minhhunghuynh/BA2-LIFI-communication/ba2-eit-lifi-main 2/Arduino/readme.md

# Arduino

Ce dossier contient les codes Arduino lié au projet 

Chaque code est accompagné de son schéma de connexion, de son *flowchart* et d'un *readme* expliquant son fonctionnement global.  
De plus, le code est commenté pour faciliter sa lecture.

Les schémas de connexion sont réalisés avec [KiCad](https://www.kicad.org) et les *flowcharts* avec [draw.io](https://www.drawio.com/).

## testRuban

Ce code permet de tester le fonctionnement d'un ruban LED en utilisant une *PWM output*.
