minhhunghuynh/BA2-LIFI-communication/ba2-eit-lifi-main 2/Documentation/readme.md

# Documentation

Ce dossier contient les documents utiles au projet :

- *documents de référence.md* contient les liens vers le cahier des charges et les notices des composanst fournis par la filière
