minhhunghuynh/BA2-LIFI-communication/ba2-eit-lifi-main 2/Gestion/Status reports/Q1/status_report_24_10_03.md

# Status report

- Groupe : 3
- Date : 3/10/2024

## Ordre du jour

- [Plan d'ensemble](#plan-d'ensemble)
- [Activités](#activités)
- [Risques et problèmes](#risques-et-problèmes)
- [Discussion de contenu](#discussions-de-contenu)

## Plan d'ensemble
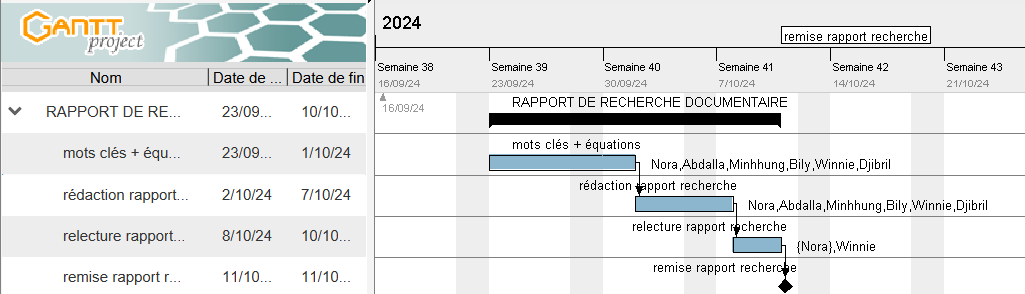
[picture p1: ba2-eit-lifi-main 2/Gestion/Status reports/plans ( images)/gantt_3_10.png]


## Activités
| Activités terminées la semaine passée | Activités planifiées la semaine prochaine | 
| --- | --- |
|Trouver les mots-clés pour la recherche documentaire |Recherche documentaire (trouver deux sources max par équation de recherche) |
|Chercher les infos sur les circuits(3 personnes responsable)  |Terminer la bibliographie pour dimanche au plus tard |
|Chercher et se renseigner sur le code en C++ (3 personnes nécessaire)  |Bily, Winnie et Minhhung vont devoir trouver un circuit test pour la semaine prochaine et comprendre comment cabler|
|  |(Djibril, Nora et Abdalla) vont devoir ramener pour la semaine prochaine un code pour faire allumer la lampe LED, test code|

## Risques et problèmes

Sous forme de **tableaux** mais en _Markdown_ pur, **il n'est pas possible d'afficher plusieurs lignes par cellule**.

**Solution 1** : utilisation d'une seule ligne par cellule et de la balise html `<br>` pour passer à la ligne

| Impact \ Probability | Medium | High | Issue  |
| --- | --- | --- | --- |
| **Medium** | **X** | <br> | |
| **High** | - pas de prototype<br>-prototype non fonctionnel |  | :warning: Problème à grand impact |

**Solution 2** : utilisation d'une rangée intermédiaire vide et de rangées supplémentaires en dessous de la ligne correspondante

| Impact \ Probability 	| Medium 	| High 	| Issue |
| -- 				 	| -- 		| -- 	| -- 	|
|  			 	 	|  		 |  	 |  	 |
| **High** 				| Risque 1 	| 	| 	|
|  				 	| Risque 2 	| 	| 	|
|  					 | 		 | 	| :warning:  Problème à grand impact |
|  				 	 |  		 |  	 |  	 |
| **Medium**			| **X**	| Risque 1 élevé | 	|
|  						| 		| Risque 2 élevé | 	|

**Solutions alternatives** : faites preuves d'imagination 

**NB** : pour la solution 1, l'impact medium se trouve en rangée 1 tandis que pour la solution 2, c'est l'inverse (cf. graphique du status_report original). A vous de choisir, ce que vous préférez comme solution. 

## Discussions de contenu
