minhhunghuynh/BA2-LIFI-communication/ba2-eit-lifi-main 2/Gestion/Status reports/Q1/status_report_24_11_28.md

# Status report

- Groupe : 3
- Date : 28/11/2024

## Ordre du jour

- [Plan d'ensemble](#plan-d'ensemble)
- [Activités](#activités)
- [Risques et problèmes](#risques-et-problèmes)
- [Discussion de contenu](#discussions-de-contenu)

## Plan d'ensemble
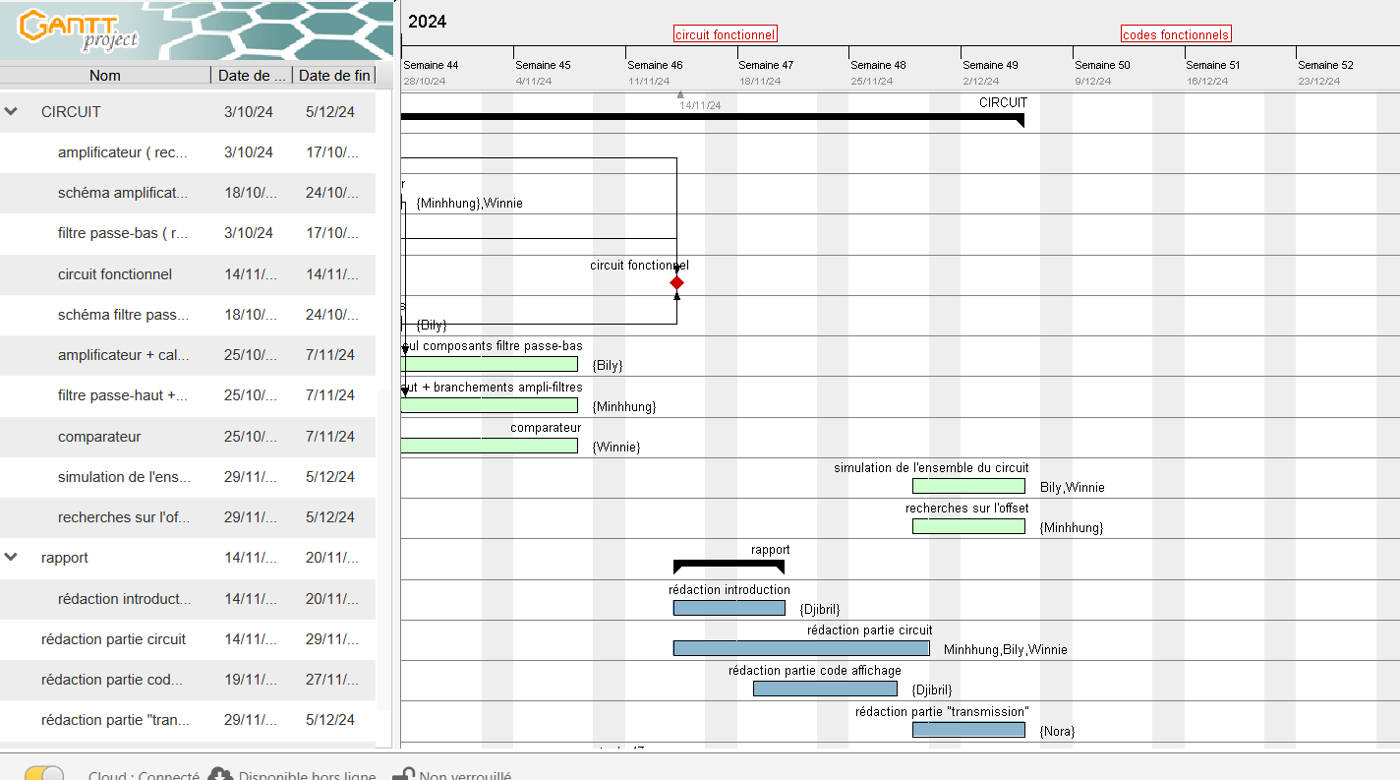
[picture p3: ba2-eit-lifi-main 2/Gestion/Status reports/plans ( images)/gantt 28_11_02.png]

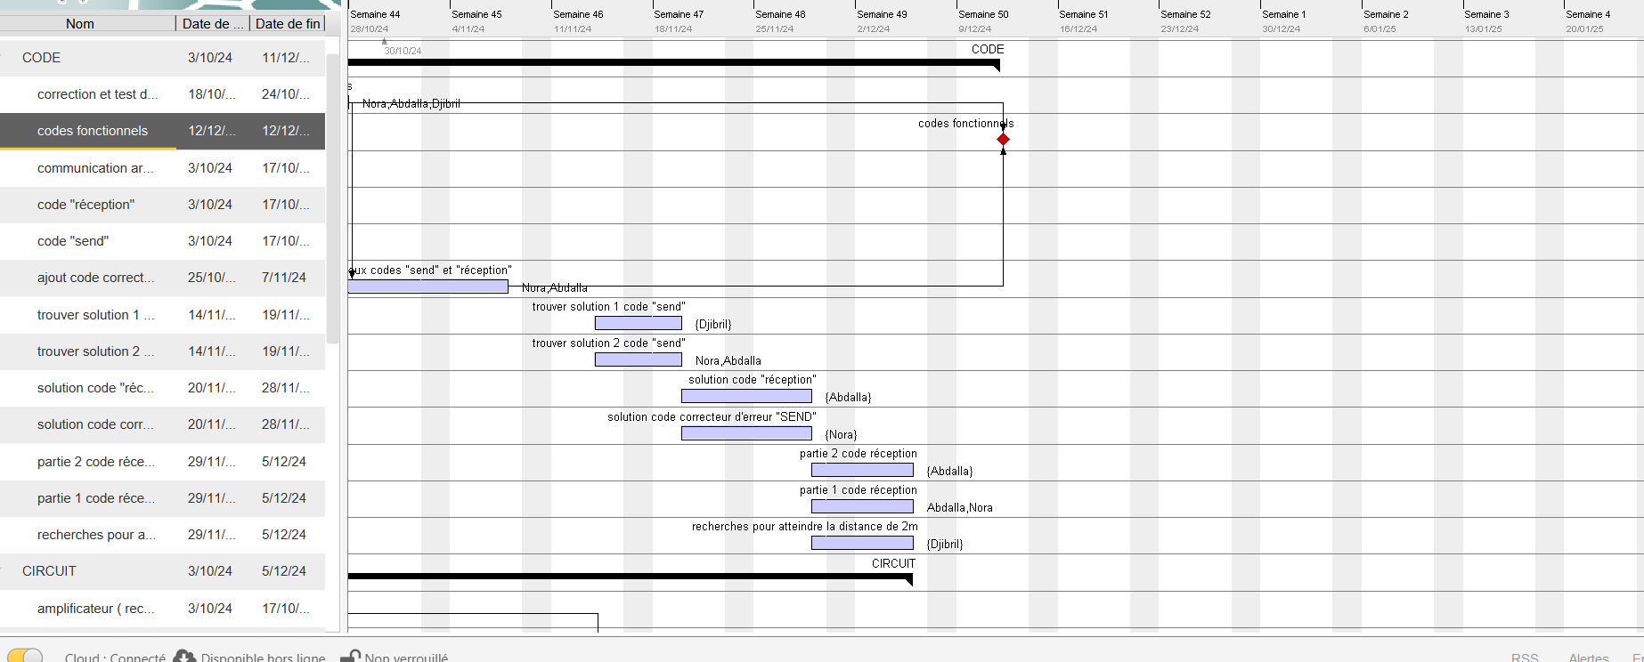
[picture p4: ba2-eit-lifi-main 2/Gestion/Status reports/plans ( images)/gantt_28_11_24.png]


## Activités
| Activités terminées la semaine passée | Activités planifiées la semaine prochaine | 
| --- | --- |
|rechercher comment avoir les informations à partir du central node en lui-même (Djibril) |trouver pourquoi le SEND fonctionne seulement a 90 cm (Djibril)|
|code correcteur SEND(Nora) |  trouver pourquoi le code correcteur ne fonctionne pas et redaction du rapport (Nora)| 
|solution code réception (Abdalla) | reajustement de son code et ecriture du rapport(Abdalla)| 
|simulation de l'ensemble du circuit avec remplacement de l'amplificateur du convertisseur courant-tension (Bily & Winnie)| tester l'ensemble du circuit avec le central node (Bily & Winnie)|
|faire la structure du rapport (Minhhung)|trouver les caracteristiques de l'offset et refaire la structure de la partie circuit du rapport (Minh)|

## Risques et problèmes

Sous forme de **tableaux** mais en _Markdown_ pur, **il n'est pas possible d'afficher plusieurs lignes par cellule**.

**Solution 1** : utilisation d'une seule ligne par cellule et de la balise html `<br>` pour passer à la ligne

| Impact \ Probability | Medium | High | Issue  |
| --- | --- | --- | --- |
| **Medium** | **X** |" Code correcteur ne fonctionne pas"| 
| **High** | -  pas de possibilité de réellement tester les codes sans circuit fonctionnel <br>  |  |

**Solution 2** : utilisation d'une rangée intermédiaire vide et de rangées supplémentaires en dessous de la ligne correspondante

| Impact \ Probability 	| Medium 	| High 	| Issue |
| -- 				 	| -- 		| -- 	| -- 	|
|  			 	 	|  		 |  	 |  	 |
| **High** 				| Risque 1 	| 	| 	|
|  				 	| Risque 2 	| 	| 	|
|  					 | 		 | 	| :warning:  Problème à grand impact |
|  				 	 |  		 |  	 |  	 |
| **Medium**			| **X**	| Risque 1 élevé | 	|
|  						| 		| Risque 2 élevé | 	|

**Solutions alternatives** : faites preuves d'imagination 

**NB** : pour la solution 1, l'impact medium se trouve en rangée 1 tandis que pour la solution 2, c'est l'inverse (cf. graphique du status_report original). A vous de choisir, ce que vous préférez comme solution. 

## Discussions de contenu
prochaine phase de la réalisation du circuit : réalisation du circuit complet et faire les tests avec le central node <br> 
prochaine réunion :Chaque membre doit terminer sa partie dans le rapport du projet.
L'introduction du rapport doit être terminée et comprehensible cette semaine.
Nora & Abdalla devront reajuster et revérifier le code correcteur
