minhhunghuynh/BA2-LIFI-communication/ba2-eit-lifi-main 2/Gestion/Status reports/Q1/status_report_24_12_05.md

# Status report

- Groupe : 3
- Date : 05/12/2024

## Ordre du jour

- [Plan d'ensemble](#plan-d'ensemble)
- [Activités](#activités)
- [Risques et problèmes](#risques-et-problèmes)
- [Discussion de contenu](#discussions-de-contenu)

## Plan d'ensemble

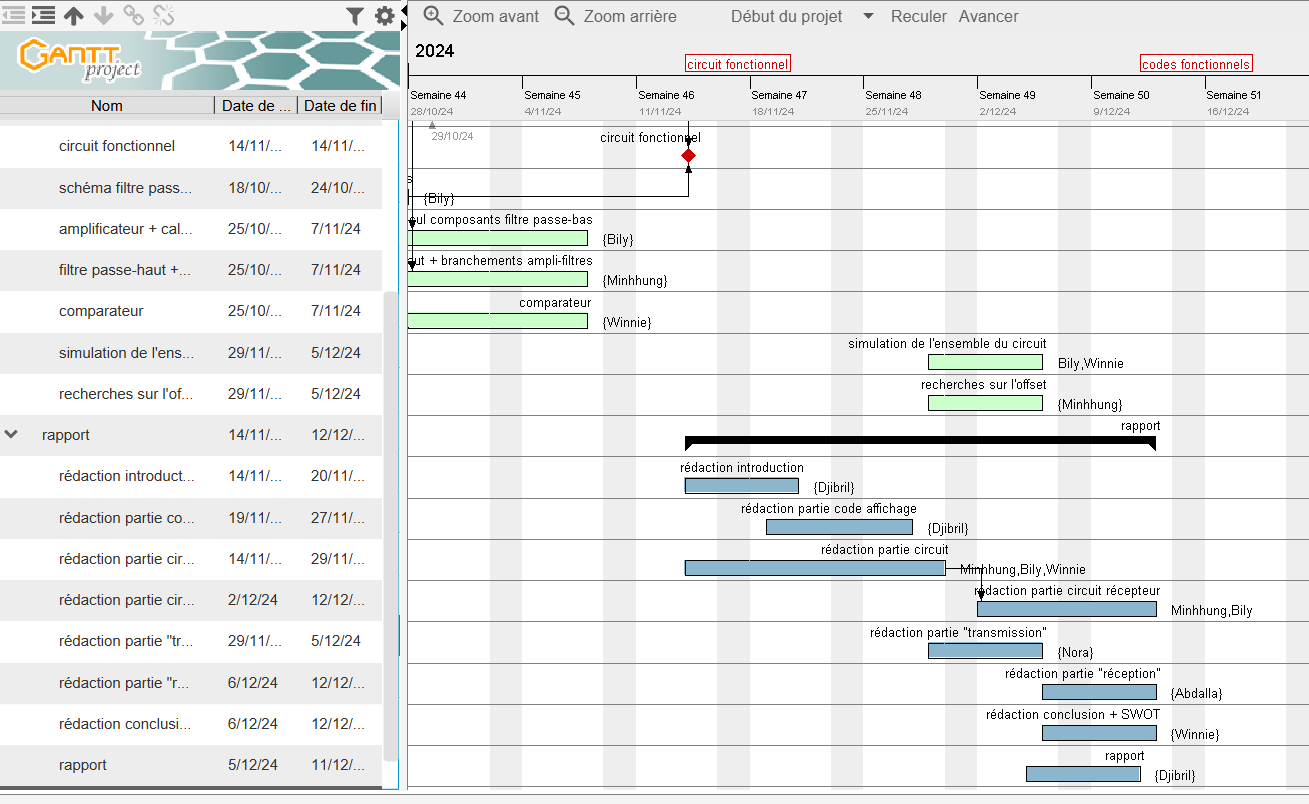
[picture p5: ba2-eit-lifi-main 2/Gestion/Status reports/plans ( images)/gantt_05_12.png]

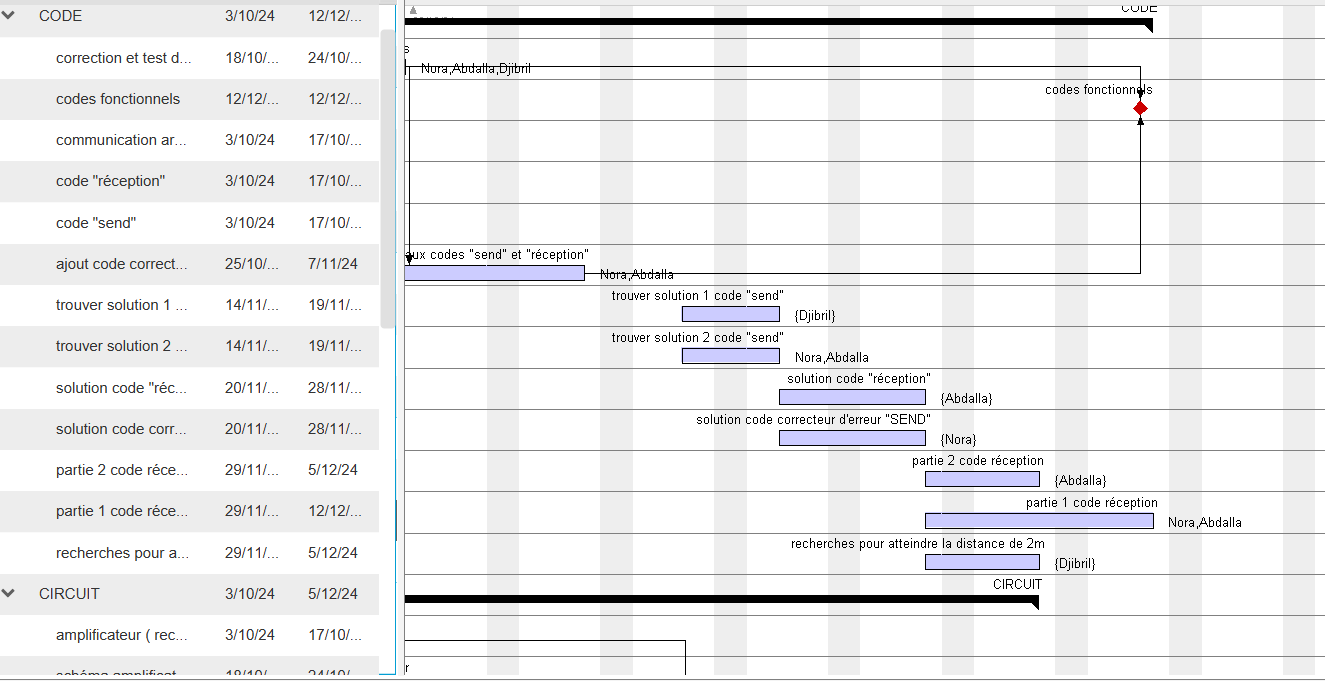
[picture p6: ba2-eit-lifi-main 2/Gestion/Status reports/plans ( images)/gantt_05_12_02.png]


## Activités
| Activités terminées la semaine passée | Activités planifiées la semaine prochaine | 
| --- | --- |
|solutions pour que le central node capte le signal lumineux jusque 2m de distance (Djibril) |rédaction du rapport + recherche de solutions pour tester le code réception sans le circuit (Djibril)|
|code correcteur et rédaction de la partie "transmission" dans le rapport (Nora)| correction de la première partie du code réception (Nora)| 
|seconde partie du code réception (Abdalla) | correction de la première partie du code réception rédaction du rapport (Abdalla)| 
|rédaction de la partie "comparateur" du rapport +  test de l'ensemble du circuit avec le central node (Winnie)| rédaction conclusion, SWOT et amélioration de l'introduction du rapport (Winnie)|
|rédaction de la première partie de la section "circuit récepteur" dans le rapport + recherches sur l'offset (Minhhung)|mesures des signaux de chaque partie du circuit + rédaction du rapport(Minhhung)|
|test de l'ensemble du circuit avec le central node + réalisation du circuit sur kicad (Bily)|rédaction du rapport (Bily)|

## Risques et problèmes

Sous forme de **tableaux** mais en _Markdown_ pur, **il n'est pas possible d'afficher plusieurs lignes par cellule**.

**Solution 1** : utilisation d'une seule ligne par cellule et de la balise html `<br>` pour passer à la ligne

| Impact \ Probability | Medium | High | Issue  |
| --- | --- | --- | --- |
| **Medium** | **X** |" Code réception ne fonctionne pas"<br>rédaction du rapport a pris du retard <br> problèmes d'affichage sur l'oscilloscope| 
| **High** | -  pas de possibilité de réellement tester les codes sans circuit fonctionnel <br>  |  |

**Solution 2** : utilisation d'une rangée intermédiaire vide et de rangées supplémentaires en dessous de la ligne correspondante

| Impact \ Probability 	| Medium 	| High 	| Issue |
| -- 				 	| -- 		| -- 	| -- 	|
|  			 	 	|  		 |  	 |  	 |
| **High** 				| Risque 1 	| 	| 	|
|  				 	| Risque 2 	| 	| 	|
|  					 | 		 | 	| :warning:  Problème à grand impact |
|  				 	 |  		 |  	 |  	 |
| **Medium**			| **X**	| Risque 1 élevé | 	|
|  						| 		| Risque 2 élevé | 	|

**Solutions alternatives** : faites preuves d'imagination 

**NB** : pour la solution 1, l'impact medium se trouve en rangée 1 tandis que pour la solution 2, c'est l'inverse (cf. graphique du status_report original). A vous de choisir, ce que vous préférez comme solution. 

## Discussions de contenu
Q2 : tester d'autres combinaisons de capacités et de résistances pour optimiser le signal
jeudi 12/12 : transfert et partage des connaissances acquises depuis le début du Q1
