minhhunghuynh/BA2-LIFI-communication/ba2-eit-lifi-main 2/Gestion/Status reports/Q2/status_report_25_02_11.md

# Status report

- Groupe : 3
- Date : 11/02/2025

## Ordre du jour

- [Plan d'ensemble](#plan-d'ensemble)
- [Activités](#activités)
- [Risques et problèmes](#risques-et-problèmes)
- [Discussion de contenu](#discussions-de-contenu)

## Plan d'ensemble

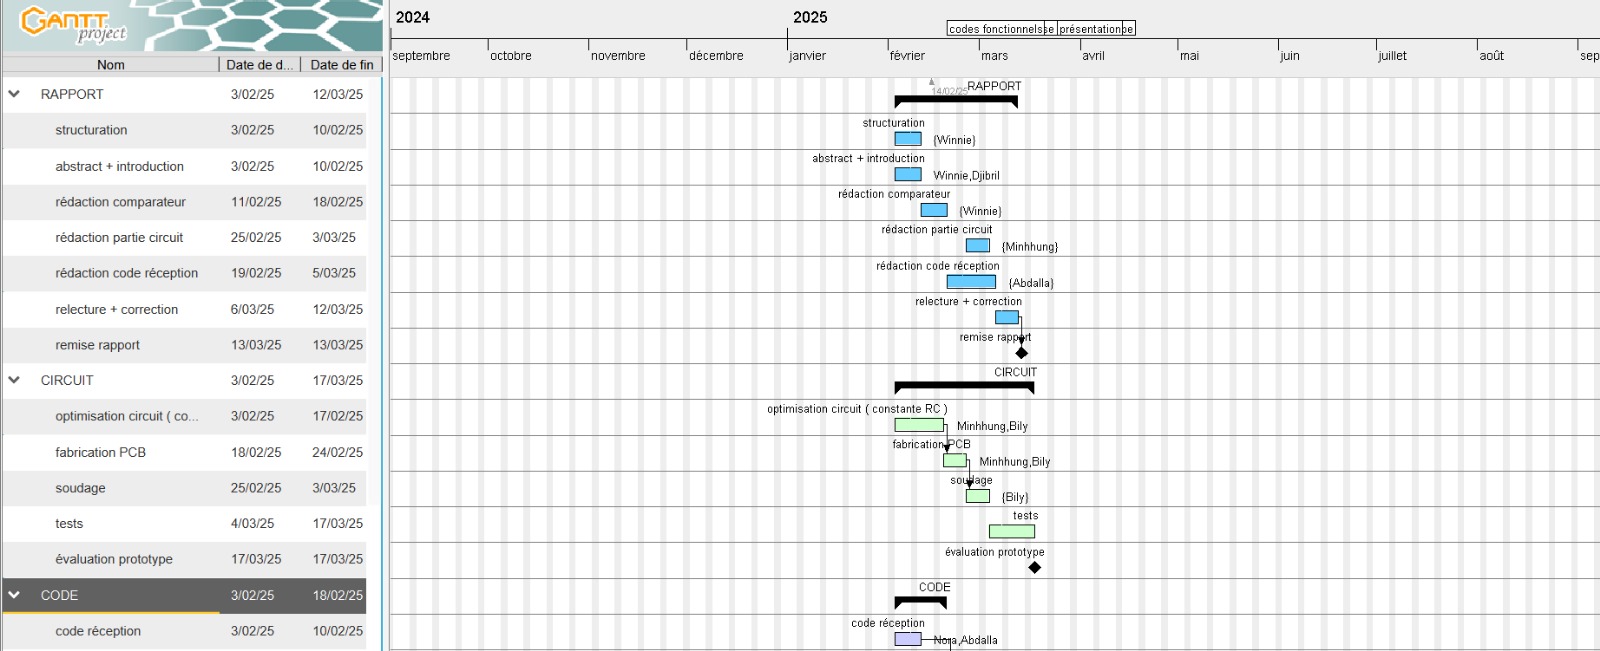
[picture p7: ba2-eit-lifi-main 2/Gestion/Status reports/plans ( images)/Gantt_11_02_25.jpg]


## Activités
| Activités terminées la semaine passée | Activités planifiées la semaine prochaine | 
| --- | --- |
|Rédaction de l'introduction et de l'abstract  |tester l'envoi et la réception du signal à 2m (Minhhung,Bily)|
|code correcteur |  trouver pourquoi le code correcteur ne fonctionne pas (Nora,Abdalla).| 
|correction du code correcteur et de l'affichage du code| reajustement du code recepteur (Abdalla,Nora,Djibril)| 
|simulation de l'ensemble du circuit et test du comparateur| tester l'ensemble du circuit avec le central node (Bily,Winnie,Minhhung)|
||redaction du rapport (Winnie,Minhhung,Billy)
| |Rédaction rapport partie circuit (Bily,Winnie et Minhhung) & realistion du circuit sur kicad(Bily)|

## Risques et problèmes

Sous forme de **tableaux** mais en _Markdown_ pur, **il n'est pas possible d'afficher plusieurs lignes par cellule**.

**Solution 1** : utilisation d'une seule ligne par cellule et de la balise html `<br>` pour passer à la ligne

| Impact \ Probability | Medium | High | Issue  |
| --- | --- | --- | --- |
| **Medium** | **X** |" Code correcteur et récepteur ne fonctionnent pas"| 
| **High** | -  pas de possibilité de réellement tester les codes sans circuit fonctionnel <br>  |  |

**Solution 2** : utilisation d'une rangée intermédiaire vide et de rangées supplémentaires en dessous de la ligne correspondante

| Impact \ Probability 	| Medium 	| High 	| Issue |
| -- 				 	| -- 		| -- 	| -- 	|
|  			 	 	|  		 |  	 |  	 |
| **High** 				| Risque 1 	| 	| 	|
|  				 	| Risque 2 	| 	| 	|
|  					 | 		 | 	| :warning:  Problème à grand impact |
|  				 	 |  		 |  	 |  	 |
| **Medium**			| **X**	| Risque 1 élevé | 	|
|  						| 		| Risque 2 élevé | 	|

**Solutions alternatives** : faites preuves d'imagination 

**NB** : pour la solution 1, l'impact medium se trouve en rangée 1 tandis que pour la solution 2, c'est l'inverse (cf. graphique du status_report original). A vous de choisir, ce que vous préférez comme solution. 

## Discussions de contenu
Aprés cette seance nous constatons que nous sommes en retard sur le projet car le code récepteur et correcteur n'est pas encore fonctionel .
Notre prochaine étape consistera a tester le circuit à 2 m , l'optimiser et finalliser le code recepteur et correcteur ensuite de tous tester avec le code affichage et si le temps permet réaliser un PCB
