minhhunghuynh/BA2-LIFI-communication/ba2-eit-lifi-main 2/Gestion/Status reports/Q2/status_report_25_02_20.md

# Status report

- Groupe : 3
- Date : 25/02/2025

## Ordre du jour

- [Plan d'ensemble](#plan-d'ensemble)
- [Activités](#activités)
- [Risques et problèmes](#risques-et-problèmes)
- [Discussion de contenu](#discussions-de-contenu)

## Plan d'ensemble

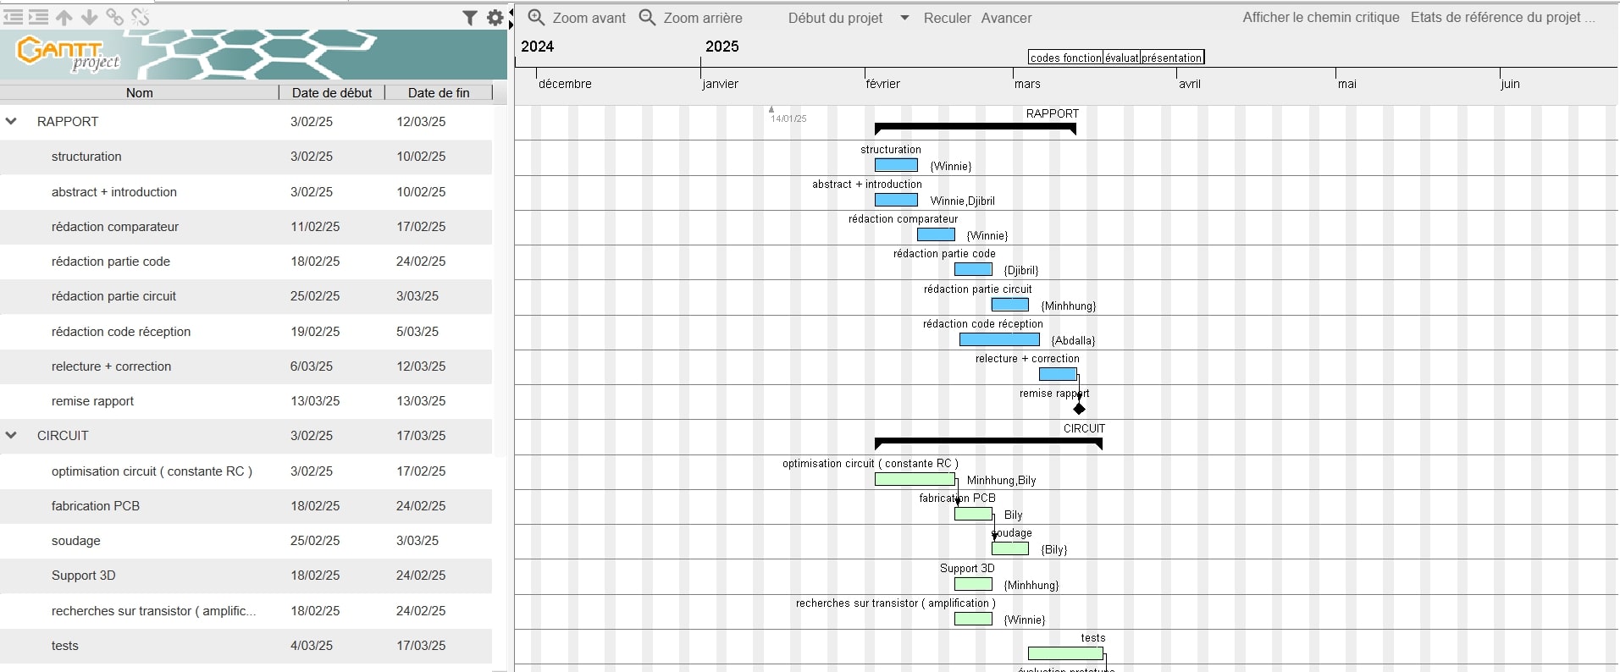
[picture p8: ba2-eit-lifi-main 2/Gestion/Status reports/plans ( images)/Capture d'écran 2025-02-24 090226.jpg]

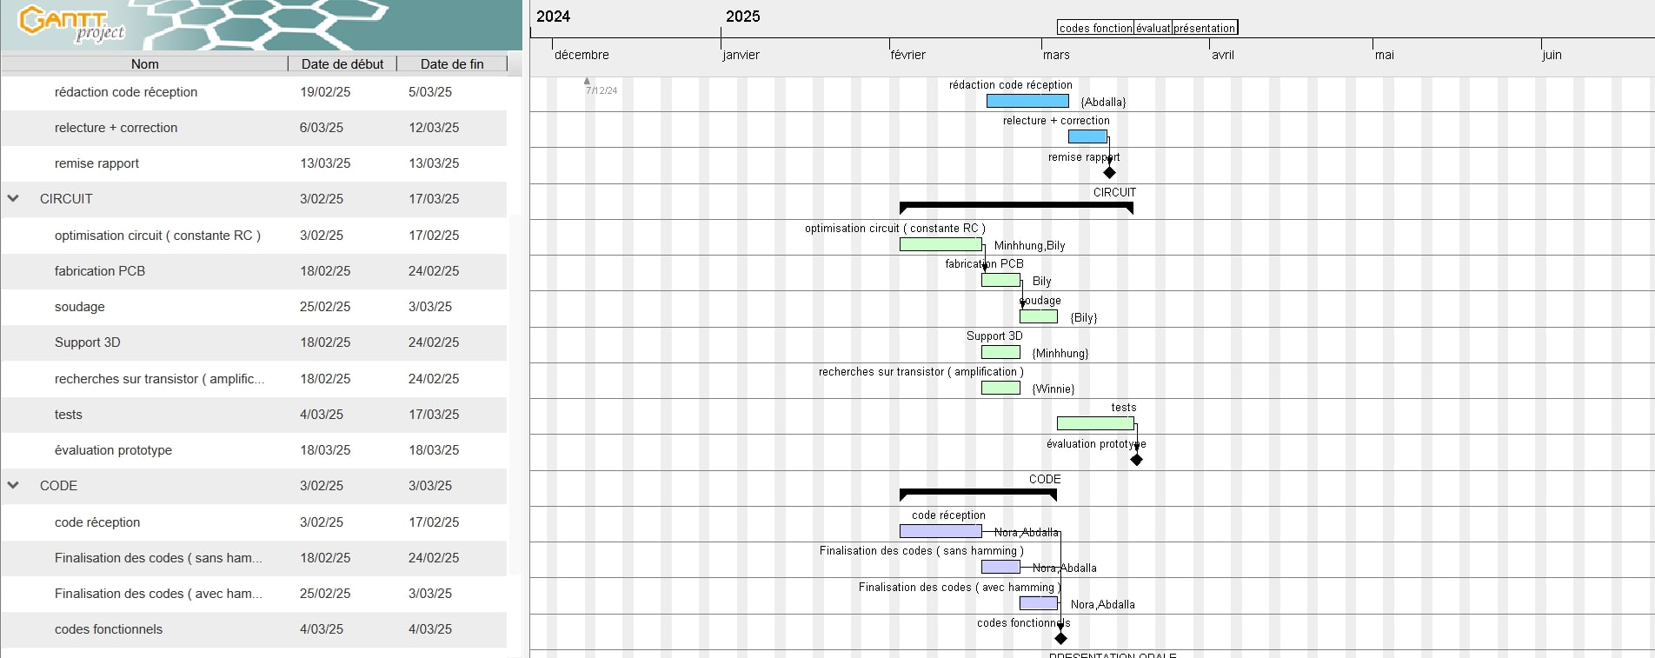
[picture p9: ba2-eit-lifi-main 2/Gestion/Status reports/plans ( images)/Capture d'écran 2025-02-24 090237.jpg]


## Activités
| Activités terminées la semaine passée | Activités planifiées la semaine prochaine | 
| --- | --- |
|tester l'ensemble du circuit avec le central node |tester l'envoi et la réception du signal à 2m (Minhhung,Bily)|
|trouver pourquoi le code correcteur ne fonctionne pas & reajustement du code recepteur  | Finalisation des codes (Nora,Abdalla) | 
|redaction du rapport partie circuit | Trouver comment utiliser un transistor pour l'amplification du signal(Winnie)|
| |Rédaction rapport partie circuit (Bily et Minhhung) & commande du PCB(Bily) & Impression 3D du support (Minhhung)|
| |Rédaction du rapport partie code(Djibril)|

## Risques et problèmes

Sous forme de **tableaux** mais en _Markdown_ pur, **il n'est pas possible d'afficher plusieurs lignes par cellule**.

**Solution 1** : utilisation d'une seule ligne par cellule et de la balise html `<br>` pour passer à la ligne

| Impact \ Probability | Medium | High | Issue  |
| --- | --- | --- | --- |
| **Medium** | **X** |" Code correcteur et récepteur ne fonctionnent pas"| 
| **High** | -  pas de possibilité de réellement tester les codes sans circuit fonctionnel <br>  |  |
| | - Central node qui n'est plus fontionnel  <br>  |  | 
| | - Composant du circuit qui crache  <br>  |  |

**Solution 2** : utilisation d'une rangée intermédiaire vide et de rangées supplémentaires en dessous de la ligne correspondante

| Impact \ Probability 	| Medium 	| High 	| Issue |
| -- 				 	| -- 		| -- 	| -- 	|
|  			 	 	|  		 |  	 |  	 |
| **High** 				| Risque 1 	| 	| 	|
|  				 	| Risque 2 	| 	| 	|
|  					 | 		 | 	| :warning:  Problème à grand impact |
|  				 	 |  		 |  	 |  	 |
| **Medium**			| **X**	| Risque 1 élevé | 	|
|  						| 		| Risque 2 élevé | 	|

**Solutions alternatives** : faites preuves d'imagination 

**NB** : pour la solution 1, l'impact medium se trouve en rangée 1 tandis que pour la solution 2, c'est l'inverse (cf. graphique du status_report original). A vous de choisir, ce que vous préférez comme solution. 

## Discussions de contenu
Aprés cette seance nous constatons que nous sommes toujours en retard sur le projet car le code récepteur et correcteur ne pas encore correctement fonctionels .
Notre prochaine étape consistera à tester le circuit à 2 m ,  finaliser le code recepteur et correcteur ensuite modifier le code affichage . Nous pourrons par la suite tester tout notre prototype ce qui nous permettra de commander le PCB et d'imprimer le support afin d'obtenir le prototype final.
