minhhunghuynh/BA2-LIFI-communication/ba2-eit-lifi-main 2/Documentation/datasheets.md

# Liens vers les notices des composants

- [Arduino Uno](https://docs.arduino.cc/hardware/uno-rev3)
- Photodiode : [BPW34](https://www.vishay.com/docs/81521/bpw34.pdf)
- [Ruban LED](https://docs.rs-online.com/6bb2/0900766b816d5c11.pdf)
