minhhunghuynh/BA2-LIFI-communication/ba2-eit-lifi-main 2/Gestion/Status reports/Q1/status_report_24_10_01.pdf

# Status Report EIT GROUPE 3

01/10/2024

## Ordre du jour

- Activités
- Risques et problèmes
- Discussion de contenu

2

## Activités

Activités terminées la semaine passée
- Se renseigner sur le
fonctionnement de l’arduino
- Faire les équations de recherche

Activités planifiées la semaine prochaine
- Faire la recherche
bibliographique pour chaque équation de recherche
- Mettre toutes les recherches dans le document Latex
- 3 -

In parentheses: (Owner – target date)

## Risques et problèmes

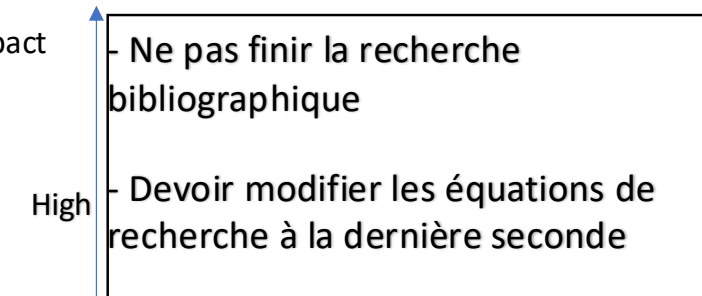
[picture p44: figure]
High; - Ne pas finir la recherche bibliographique; - Devoir modifier les équations de recherche à la dernière seconde

Impact

Medium

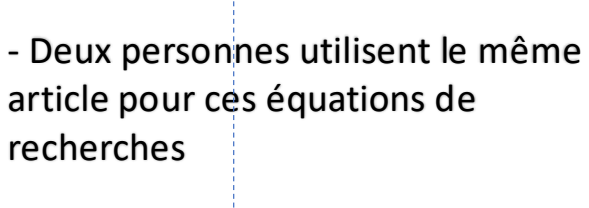
[picture p45: figure]
- Deux personnes utilisent le même article pour ces équations de recherches

Medium | High | Probability

## Discussions de contenu

- Fonctionnement de l’arduino : - micro-contrôleur
- Permet d’éxecuter des programmes
- Contrôler les périphériques externes
- Composé de 3 broches
- Assemblage des mots-clés et pertinence des équations

5
