minhhunghuynh/BA2-LIFI-communication/ba2-eit-lifi-main 2/Gestion/Status reports/Q1/Status_report_24_11_21.pdf

# Projet Status Report

21/11/2024

## Ordre du jour

- Activités
- Risques et problèmes
- Planification

2

## Activités terminées

Activités terminées la semaine passée
- Comparateur terminé
- Préamplificateur avec filtre passe-bas et amplificateur avec filtre passe-haut terminé
- Code send terminé
- 3 -

In parentheses: (Owner – target date)

## Risques et problèmes

- Pas très avancé sur le rapport
- On a que le code Send qui fonctionne, les autres codes ne fonctionnent pas
- Le comparateur fonctionne mais quand on l’attache au reste du circuit, il ne fonctionne plus
- On n’a toujours pas essayé de tester le circuit avec la LED opérationnel

## planification

5

- Avancer sur le rapport
- Finir le code récepteur
- Faire le offset
