minhhunghuynh/BA2-LIFI-communication/ba2-eit-lifi-main 2/Arduino/Code "SEND"/readme.md

Ce code permet d'envoyer le paquet SEND, constitué de la chaîne de caractères "SEND" pour initier la transaction entre le User Node et le Central Node. Le paquet est envoyé sous forme de signal lumineux en modulation "On-Off Keying".
