minhhunghuynh/BA2-LIFI-communication/ba2-eit-lifi-main 2/Gestion/Status reports/Q1/status_report_24_10_08.md

# Status report

- Groupe : 3
- Date : 08/10/2024

## Ordre du jour

- [Plan d'ensemble](#plan-d'ensemble)
- [Activités](#activités)
- [Risques et problèmes](#risques-et-problèmes)
- [Discussion de contenu](#discussions-de-contenu)

## Plan d'ensemble

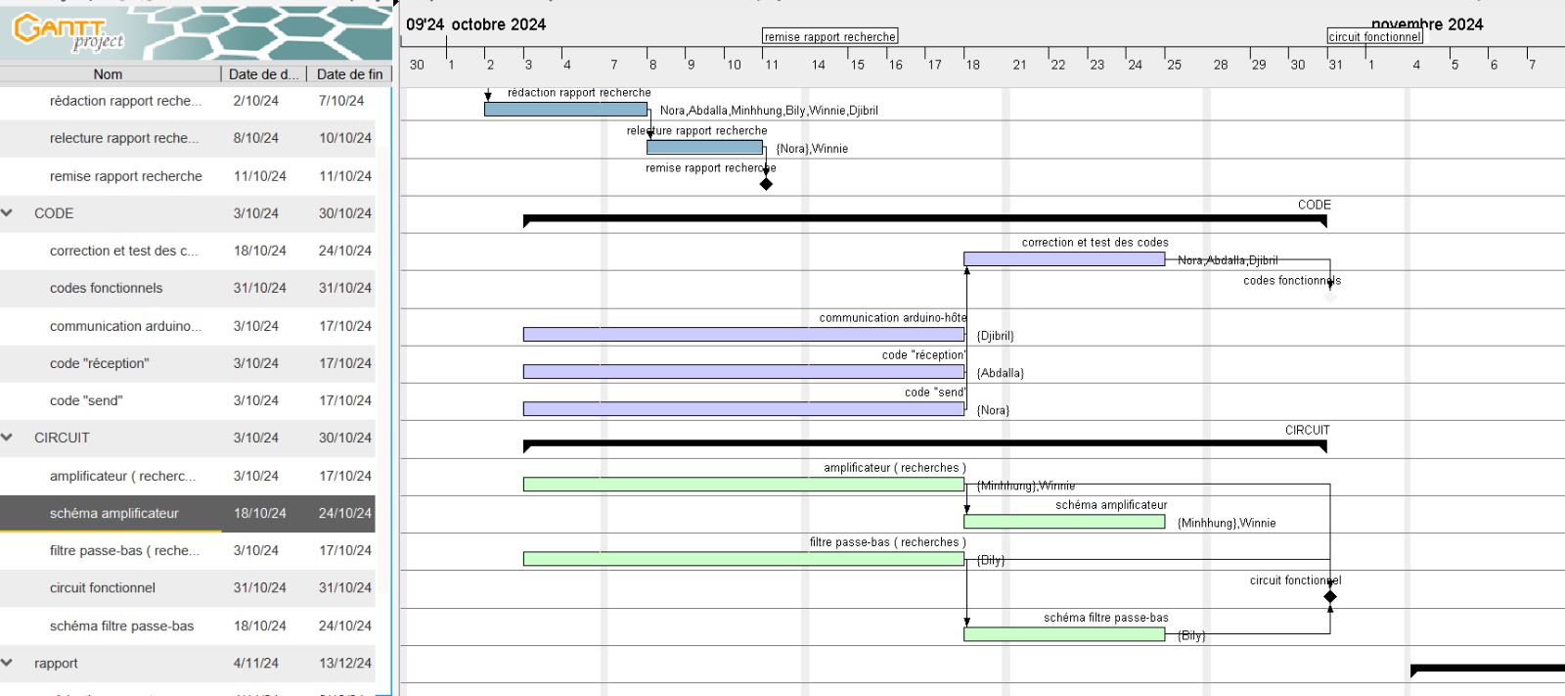
[picture p46: ba2-eit-lifi-main 2/Gestion/Status reports/plans ( images)/gantt pour satut report 17.jpeg]


## Activités
| Activités terminées la semaine passée | Activités planifiées la semaine prochaine | 
| --- | --- |
|Recherches sur le fonctionnement du language c++ (Djibril) |Code d'affichage de l'image (Djibril)|
|Un exemple de code avec le language c++ (Nora et Abdalla) |partie "SEND" du code (Nora)|
| | Partie recepteur du code(Abdalla) | 
|recherches et compréhension du circut(Bily, Winnie, Minhhung)|Schéma du filtre passe bas(Bily)|
||Schéma de l'amplificateur (Minhhung, Winnie)|

## Risques et problèmes

Sous forme de **tableaux** mais en _Markdown_ pur, **il n'est pas possible d'afficher plusieurs lignes par cellule**.

**Solution 1** : utilisation d'une seule ligne par cellule et de la balise html `<br>` pour passer à la ligne

| Impact \ Probability | Medium | High | Issue  |
| --- | --- | --- | --- |
| **Medium** | **X** | -décalage des "milestones"| 
| **High** | -  pas de possibilité de réellement tester les codes sans circuit fonctionnel <br> -signal instable + brouillé |  |

**Solution 2** : utilisation d'une rangée intermédiaire vide et de rangées supplémentaires en dessous de la ligne correspondante

| Impact \ Probability 	| Medium 	| High 	| Issue |
| -- 				 	| -- 		| -- 	| -- 	|
|  			 	 	|  		 |  	 |  	 |
| **High** 				| Risque 1 	| 	| 	|
|  				 	| Risque 2 	| 	| 	|
|  					 | 		 | 	| :warning:  Problème à grand impact |
|  				 	 |  		 |  	 |  	 |
| **Medium**			| **X**	| Risque 1 élevé | 	|
|  						| 		| Risque 2 élevé | 	|

**Solutions alternatives** : faites preuves d'imagination 

**NB** : pour la solution 1, l'impact medium se trouve en rangée 1 tandis que pour la solution 2, c'est l'inverse (cf. graphique du status_report original). A vous de choisir, ce que vous préférez comme solution. 

## Discussions de contenu
Des modifications doivent être faites sur le rapport de recherche documentaire
Les taches de la semaine dernière n'ont pas été très bien faites donc il faudra y remedier dans l'avenir et chacun devra faire une présentation de ce sur quoi il a travaillé pendant la semaine.
