minhhunghuynh/BA2-LIFI-communication/ba2-eit-lifi-main 2/Gestion/Status reports/Q1/status_report_24_10_17.md

# Status report

- Groupe : 3
- Date : 17/10/2024

## Ordre du jour

- [Plan d'ensemble](#plan-d'ensemble)
- [Activités](#activités)
- [Risques et problèmes](#risques-et-problèmes)
- [Discussion de contenu](#discussions-de-contenu)

## Plan d'ensemble



## Activités
| Activités terminées la semaine passée | Activités planifiées la semaine prochaine | 
| --- | --- |
|Recherches Code affichage (Djibril) |Code affichage terminé (Djibril)|
|Recherches Code envoi du send (Nora) |Code envoi du send (Nora)|
|Recherches code réception du paquet du central node ( Abdalla) |code réception du paquet du central node ( Abdalla)|
|Récherches sur le filtre passe-bas (billy)|circuit le filtre passe-bas (billy)|
|Récherches sur l'amplificateur (Winnie et Minhhung )|circuit sur l'amplificateur (Winnie et Minhhung )|

## Risques et problèmes

Sous forme de **tableaux** mais en _Markdown_ pur, **il n'est pas possible d'afficher plusieurs lignes par cellule**.

**Solution 1** : utilisation d'une seule ligne par cellule et de la balise html `<br>` pour passer à la ligne

| Impact \ Probability | Medium | High | Issue  |
| --- | --- | --- | --- |
| **Medium** | **X** | <br> | |
| **High** | - Impression de stagnation |  | :warning: Problème à grand impact |

**Solution 2** : utilisation d'une rangée intermédiaire vide et de rangées supplémentaires en dessous de la ligne correspondante

| Impact \ Probability 	| Medium 	| High 	| Issue |
| -- 				 	| -- 		| -- 	| -- 	|
|  			 	 	|  		 |  	 |  	 |
| **High** 				| Risque 1 	| 	| 	|
|  				 	| Risque 2 	| 	| 	|
|  					 | 		 | 	| :warning:  Problème à grand impact |
|  				 	 |  		 |  	 |  	 |
| **Medium**			| **X**	| Risque 1 élevé | 	|
|  						| 		| Risque 2 élevé | 	|

**Solutions alternatives** : faites preuves d'imagination 

**NB** : pour la solution 1, l'impact medium se trouve en rangée 1 tandis que pour la solution 2, c'est l'inverse (cf. graphique du status_report original). A vous de choisir, ce que vous préférez comme solution. 

## Discussions de contenu
Minhhung: il faut faire un amplificateur; il prend comme tache de le faire pour Mardi.

winnie : avant de démoduler le signal va falloir filter, puis utiliser un comparateur qui va permettre de traduit le signal en signal binaire . pour mardi, elle prend comme tache de venir  avec le circuit sur le comparateur .

billy : Mardi, il vient avec le circuit sur le filtre.

Nora : Mardi ,elle vient avec un code complet pour l'envoi.

Abdala: Mardi, il vient avec un code pour sa partie.

Djibril: Mardi, il vient avec le code pour l'affichage.
