minhhunghuynh/BA2-LIFI-communication/ba2-eit-lifi-main 2/Gestion/Status reports/Q2/status_report_25_03_06.md

# Status report

- Groupe : 3
- Date : 06/03/2025

## Ordre du jour

- [Plan d'ensemble](#plan-d'ensemble)
- [Activités](#activités)
- [Risques et problèmes](#risques-et-problèmes)
- [Discussion de contenu](#discussions-de-contenu)

## Plan d'ensemble



## Activités
| Activités terminées la semaine passée | Activités planifiées la semaine prochaine | 
| --- | --- |
|Rédaction de l'introduction et de l'abstract + Support 3D (Minhhung)  |terminer le rapport partie affichage (Djibril)|
|Finalisation codes (Nora) |Implémentation Hamming(7,4) dans le code réception (Nora ,Abdalla)| 
|Rédaction du rapport partie circuit |Suite rédaction partie circuit il faut mettre les images (Billy,Winnie et Minhhung)| 
|Simulations de l'ensemble du circuit (Bily)| PCB + schémas signaux (Bily) et test du circuit|
|Finalisation codes (Abdalla)|Trouver solution pour le code SEND (Abdalla)|
|Recherches sur transistor (Winnie)|Rédaction rapport partie réception (Abdalla) partie SEND ( Nora)|

## Risques et problèmes

Sous forme de **tableaux** mais en _Markdown_ pur, **il n'est pas possible d'afficher plusieurs lignes par cellule**.

**Solution 1** : utilisation d'une seule ligne par cellule et de la balise html `<br>` pour passer à la ligne

| Impact \ Probability | Medium | High | Issue  |
| --- | --- | --- | --- |
| **Medium** | **X** |Codes fonctionnent indépendamment du circuit mais pas avec| 
| **High** | Code SEND fonctionne de façon intermittente <br>  | Pas assez de Central nodes pour tous les groupes. Central node non fonctionnel|

**Solution 2** : utilisation d'une rangée intermédiaire vide et de rangées supplémentaires en dessous de la ligne correspondante

| Impact \ Probability 	| Medium 	| High 	| Issue |
| -- 				 	| -- 		| -- 	| -- 	|
|  			 	 	|  		 |  	 |  	 |
| **High** 				| Risque 1 	| 	| 	|
|  				 	| Risque 2 	| 	| 	|
|  					 | 		 | 	| :warning:  Problème à grand impact |
|  				 	 |  		 |  	 |  	 |
| **Medium**			| **X**	| Risque 1 élevé | 	|
|  						| 		| Risque 2 élevé | 	|

**Solutions alternatives** : faites preuves d'imagination 

**NB** : pour la solution 1, l'impact medium se trouve en rangée 1 tandis que pour la solution 2, c'est l'inverse (cf. graphique du status_report original). A vous de choisir, ce que vous préférez comme solution. 

## Discussions de contenu
_ Le code fonctionne par moment et souvent le Central node burg.

-Le rapport doit se terminer pour le dimanche 09-03 au plus tard. Le rédiger en tenant 
compte des remarques du Q1.

-mettre les images dans le rapport. 

Aprés un debrief sur l'avancer du sujet et la repartition du travail, nous avons fait le swot puis les léçons apprises .

Le groupe a  une grande motivation à terminer le projet et d’avoir le résultat final. Mais nous avons des problèmes au niveau du central node qui ne sont pas en Quantité et le peu que nous avons fonctionne par moment et ça freine l’avancer du projet . 
Comparer au Q1 nous avons progresser dans le projet et avons fait beaucoup de test qui ont permis de mieux comprendre le projet sur lequel nous travaillons.
