minhhunghuynh/BA2-LIFI-communication/ba2-eit-lifi-main 2/Gestion/SWOT/SWOT_Q1.md

# SWOT

| <span style="color:green;">**</span> | **Détails** |
|---|---|
| **Strengths** | - Tâches accomplies et attribuées (fiabilité) |
| | - Assez de tâches attribuées |
| | - Efforts |
| | - Pas de tensions (énergie négative) |
| | - Pas de panique / stress |
| | - Bonne communication |
| | - Réactivité |
| | - Bonne ambiance |
| <span style="color:blue;">**WEAKNESSES**</span> | - Pas d’organisation (au début) |
| | - Mauvaise estimation des durées de l’accomplissement des tâches et des deadlines |
| | - Manque d’expérience |
| | - Tâches durent longtemps |
| | - Stagnation |
| | - Pendant réunion : tout le monde parle en même temps |
| | - Réunions confuses, pas d’ordre du jour préparé |
| | - Réunions pas assez structurées |
| | - Pas assez de rigueur, justifications (rapport,...) |
| <span style="color:gold;">**OPPORTUNITIES**</span> | - Accès au laboratoire UA5 |
| <span style="color:red;">**THREATS**</span> | - Overleaf |
| | - Composants du circuit ne fonctionnent plus / pas |
| **SOLUTIONS** | - Préparer l’ordre du jour à l’avance |
