minhhunghuynh/BA2-LIFI-communication/ba2-eit-lifi-main 2/Gestion/Status reports/Q2/status_report_25_02_07.pdf

# Status Report

03/02/2025

## Ordre du jour

- Plan d’ensemble
- activités
- Risques et problèmes

2

## Plan d’ensemble

3

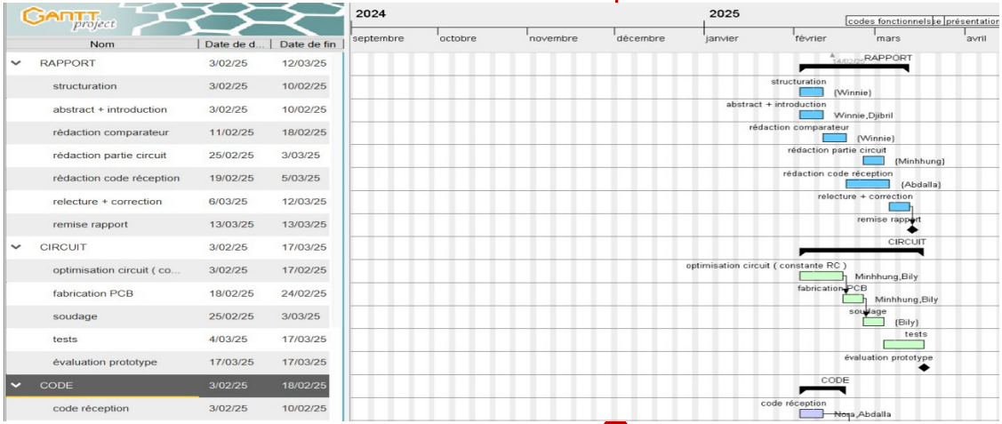
[picture p48: figure]

## Activités

Activités planifiées la semaine prochaine
- Finalisation du code émetteur (ajouter le code correcteur)
- Finalisation du code récepteur
- Tester le code affichage si les codes sont fonctionnels
- Optimiser le circuit en réduisant le temps de décharge
- 4 -

In parentheses: (Owner – target date)

## Risques et problèmes

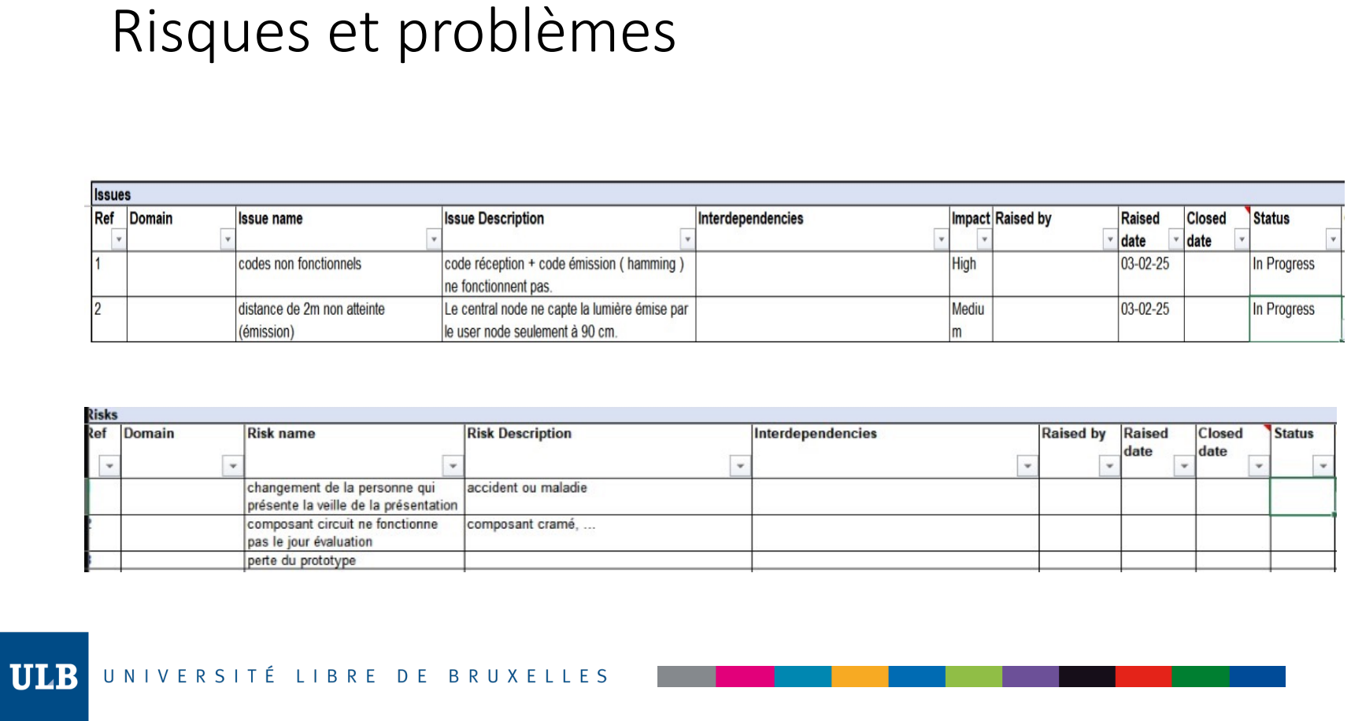
[picture p49: page 5]
