minhhunghuynh/BA2-LIFI-communication/ba2-eit-lifi-main 2/Gestion/Status reports/plans ( images)/yy_mm_dd.png

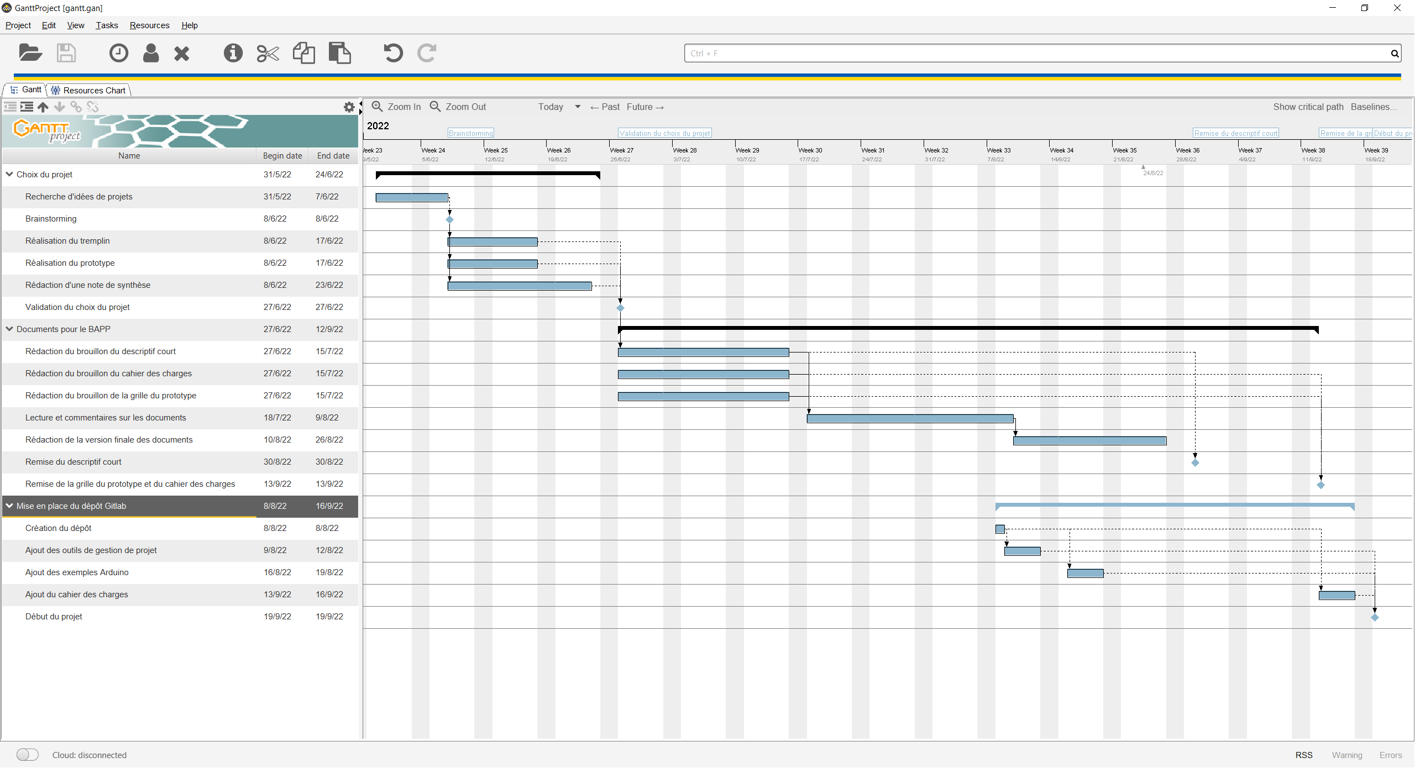
ba2-eit-lifi-main 2/Gestion/Status reports/plans ( images)/yy_mm_dd.png
