minhhunghuynh/BA2-LIFI-communication/ba2-eit-lifi-main 2/Gestion/Risques et problèmes/Risk and Issue Log.xlsx

Sheet: Issue Log
Issue Log
 | Ask what is the issue preventing from happening. What is the decision or action that is needed to move forward
Issues
Ref | Domain | Issue name | Issue Description | Interdependencies | Impact | Raised by | Raised date | Closed date | Status | Owner | Action / Solution | Comment
1
2
3
4
5
6
7
8
9
10
11
12
13
14
15
16
17
18
19
20
21
22
23
24
25
26
27
28
29
30
31
32
33
34
35
36
37
38
39
40
41
42
43
44
45
46
47
48
49
50
51
52
53
54
55
56
57
58
59
60
61
62
63
64
65
66
67
68
69
70
71
72
73
74
75
76
77
78
79
80
81
82
83
84
85
86
87
88
89
90
91
92
93
94
95
96
97
98
99
100
101
102
103
104
105
106
107
108
109
110
111
112
113
114
115
116
117
118
119
120
121
122
123
124
125
126
127
128
129
130
131
132
133
134
135
136
137
138
139
140
141
142
143
144
145
146
147
148
149
150
151
152
153
154
155
156
157
158
159
160
161
162
163
164
165
166
167
168
169
170
171
172
173
174
175
176
177
178
179
180
181
182
183
184
185
186
187
188
189
190
191
192
193
194
195
196
197
198
199
200

Sheet: Risk Log
Risk Log
 | Ask what the risk is, what causes the risk, and what are the measurable impacts the risk will have on the project
Risks
Ref | Domain | Risk name | Risk Description | Interdependencies | Raised by | Raised date | Closed date | Status | Owner | Mitigation action, if any | Last action date | Likelihood | Impact | Score | Comment
1 |  |  |  |  |  |  |  |  |  |  |  |  |  | -1 | Input Likelihood & Impact
2 |  |  |  |  |  |  |  |  |  |  |  |  |  | -1 | Input Likelihood & Impact
3 |  |  |  |  |  |  |  |  |  |  |  |  |  | -1 | Input Likelihood & Impact
4 |  |  |  |  |  |  |  |  |  |  |  |  |  | -1 | Input Likelihood & Impact
5 |  |  |  |  |  |  |  |  |  |  |  |  |  | -1 | Input Likelihood & Impact
6 |  |  |  |  |  |  |  |  |  |  |  |  |  | -1 | Input Likelihood & Impact
7 |  |  |  |  |  |  |  |  |  |  |  |  |  | -1 | Input Likelihood & Impact
8 |  |  |  |  |  |  |  |  |  |  |  |  |  | -1 | Input Likelihood & Impact
9 |  |  |  |  |  |  |  |  |  |  |  |  |  | -1 | Input Likelihood & Impact
10 |  |  |  |  |  |  |  |  |  |  |  |  |  | -1 | Input Likelihood & Impact
11 |  |  |  |  |  |  |  |  |  |  |  |  |  | -1 | Input Likelihood & Impact
12 |  |  |  |  |  |  |  |  |  |  |  |  |  | -1 | Input Likelihood & Impact
13 |  |  |  |  |  |  |  |  |  |  |  |  |  | -1 | Input Likelihood & Impact
14 |  |  |  |  |  |  |  |  |  |  |  |  |  | -1 | Input Likelihood & Impact
15 |  |  |  |  |  |  |  |  |  |  |  |  |  | -1 | Input Likelihood & Impact
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
190 |  |  |  |  |  |  |  |  |  |  |  |  |  | -1 | Input Likelihood & Impact
191 |  |  |  |  |  |  |  |  |  |  |  |  |  | -1 | Input Likelihood & Impact
192 |  |  |  |  |  |  |  |  |  |  |  |  |  | -1 | Input Likelihood & Impact
193 |  |  |  |  |  |  |  |  |  |  |  |  |  | -1 | Input Likelihood & Impact
194 |  |  |  |  |  |  |  |  |  |  |  |  |  | -1 | Input Likelihood & Impact
195 |  |  |  |  |  |  |  |  |  |  |  |  |  | -1 | Input Likelihood & Impact
196 |  |  |  |  |  |  |  |  |  |  |  |  |  | -1 | Input Likelihood & Impact
197 |  |  |  |  |  |  |  |  |  |  |  |  |  | -1 | Input Likelihood & Impact
198 |  |  |  |  |  |  |  |  |  |  |  |  |  | -1 | Input Likelihood & Impact
199 |  |  |  |  |  |  |  |  |  |  |  |  |  | -1 | Input Likelihood & Impact
200 |  |  |  |  |  |  |  |  |  |  |  |  |  | -1 | Input Likelihood & Impact

Sheet: Instructions
Issue Instructions
Issues are classified by criticality in terms of their impact if not resolved
 |  | Decreases Revenue
 | High | Causes Significant Increase in Costs (greater than 0.05% of revenue)
 |  | Significantly Disrupts Customer Relationship
 |  | Causes a Major Project Milestone to be Missed by more than a week
 |  | Slows Projected Revenue Growth
 | Medium | Causes Minor Increase in Costs (less than 0.05% of revenue)
 |  | Causes Minor Disruption to Customer Relationship
 |  | Causes a Project Deadline to be Missed
 |  | Has Little/No Impact on Revenue
 | Low | Has Little/No Impact on Costs
 |  | Has Little/No Impact on Customer Relationship
 |  | Has Little/No Impact on Meeting Project Deadlines
Risk Instructions
Risks are evaluated in terms of likelihood
 | High | The risk is very likely to occur
 | Medium | The risk may occur
 | Low | The risk will most likely not occur
What is most important about risk occurrence is the measuring the impact.
 | High | The risk occurrence will jeopardize the whole or a substantial part of the project
 | Medium | The risk occurrence will have an impact on time, quality or cost elements of the project, and will alter the end deliverable
 | Low | The risk occurrence can be resolved with reasonable effort, leaving the end deliverable unchanged
All risks do not need to be mitigated. The decision to mitigate a risk depends on the risk score
 |  |  | Reporting score
3 | 6 | 9 | Red | Big risk, need to mitigate urgently
2 | 4 | 6 | Amber | Risk needs to be mitigated
1 | 2 | 3 | Green | Can be mitigated

Sheet: Lists
Reference Lists
Here below are the lists used in the cell dropdown of the Risk and Issue logging tool. To modify those lists, simply change the cell values. To add values, insert a cell in the appropriated list. Additional changes can be made by using the "Insert\Name" menu from the toolbar.
Domain | Issue Status |  | Impact
… | New | Low | 1
… | In Progress | Medium | 2
… | Closed | High | 3
…
… | Risk Status |  | Risk Likelihood | Risk Impact
… | Open | Low | 1 | 1
General | Not Mitigated | Medium | 2 | 2
 | Closed | High | 3 | 3
