minhhunghuynh/BA2-LIFI-communication/ba2-eit-lifi-main 2/Documentation/CIRCUIT.kicad_sch

## KiCad design ba2-eit-lifi-main 2/Documentation/CIRCUIT.kicad_sch (2026-06-01)

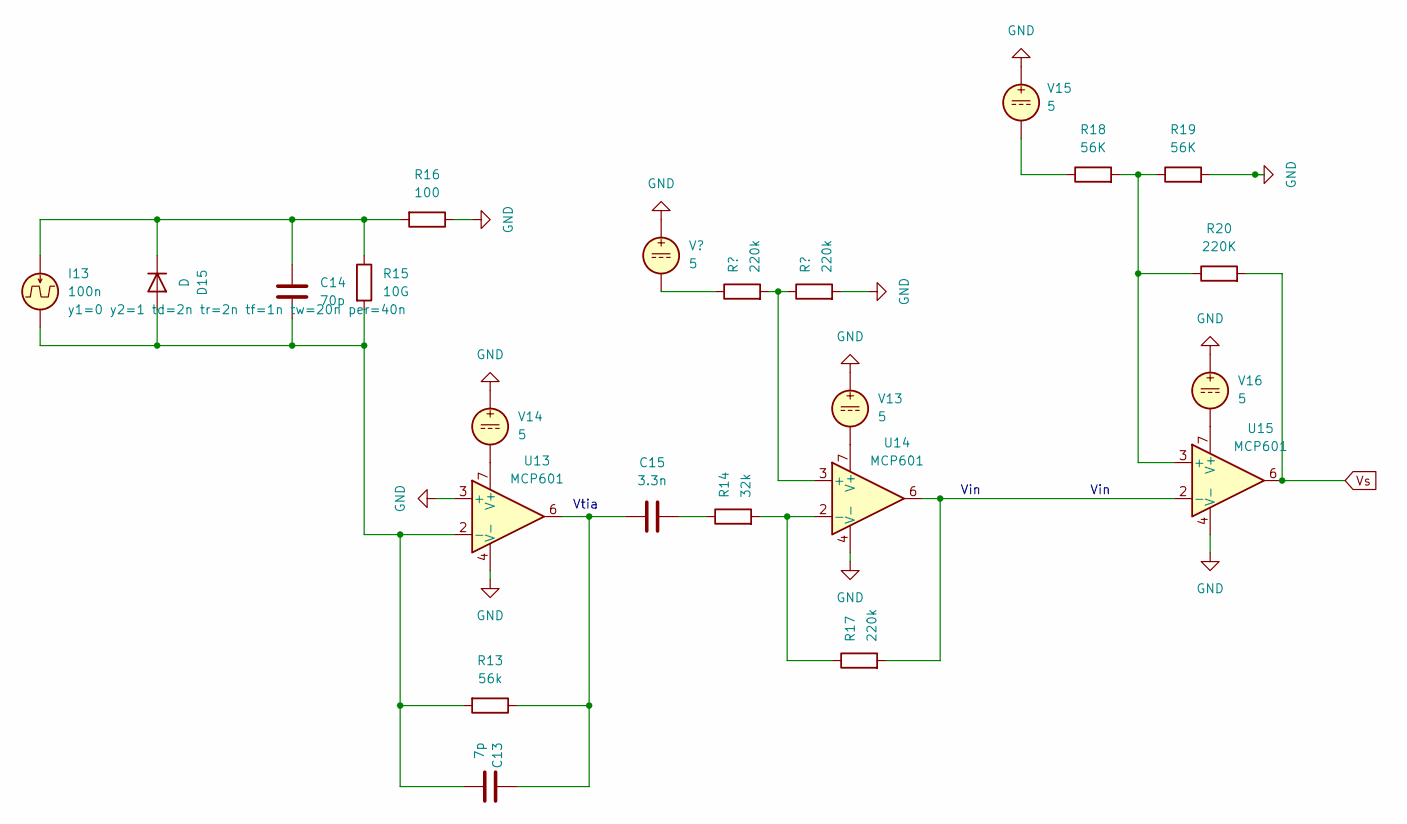
[picture p53: schematic CIRCUIT.kicad_sch]

Parts:
C13: 7p
C14: 70p
C15: 3.3n
D15: D
I13: 100n
R13: 56k
R14: 32k
R15: 10G
R16: 100
R17: 220k
R18, R19: 56K
R20: 220K
U13, U14, U15: MCP601; SOIC-8_3.9x4.9mm_P1.27mm
V13, V14, V15, V16: 5

Connections:
GND: R16.1, R19.2, U13.3 (+), U13.4 (V-), U14.4 (V-), U15.4 (V-), V13.1, V14.1, V15.1, V16.1
unnamed: C13.1, C15.1, R13.1, U13.6
unnamed: C13.2, C14.2, D15.2 (A), I13.2, R13.2, R15.2, U13.2 (-)
unnamed: C14.1, D15.1 (K), I13.1, R15.1, R16.2
unnamed: C15.2, R14.1
unnamed: R14.2, R17.1, U14.2 (-)
unnamed: R17.2, U14.6, U15.2 (-)
unnamed: R18.1, V15.2
unnamed: R18.2, R19.1, R20.1, U15.3 (+)
unnamed: U13.7 (V+), V14.2
unnamed: U14.7 (V+), V13.2
unnamed: U15.7 (V+), V16.2
Vs: R20.2, U15.6

Notes on the sheet:
Vtia
Vin
